kcerdena/light-timer/(commit log)

2021-11-27 PWM dimming with Transistor
2021-11-27 updated resistor
